SamuelHuet/SerreAutonome/Pics/cuve_filaire.PNG

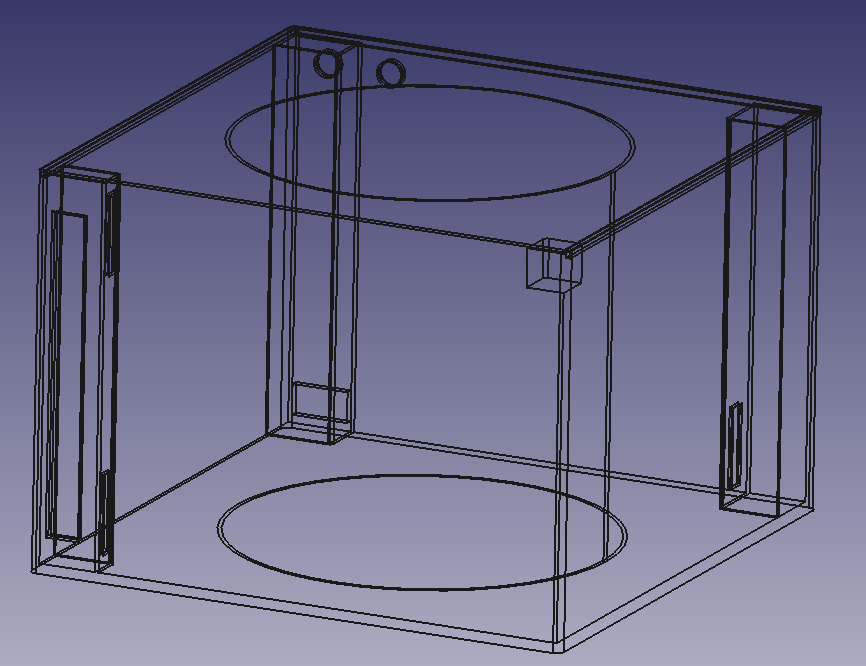
Pics/cuve_filaire.PNG
