SamuelHuet/SerreAutonome/Pics/couvercle_tete_filaire.PNG

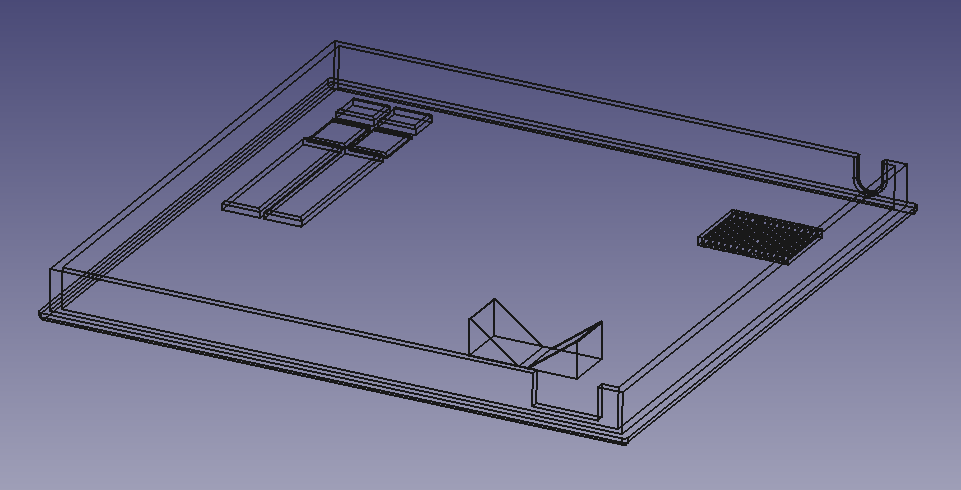
Pics/couvercle_tete_filaire.PNG
