SamuelHuet/SerreAutonome/Pics/Aroser.png

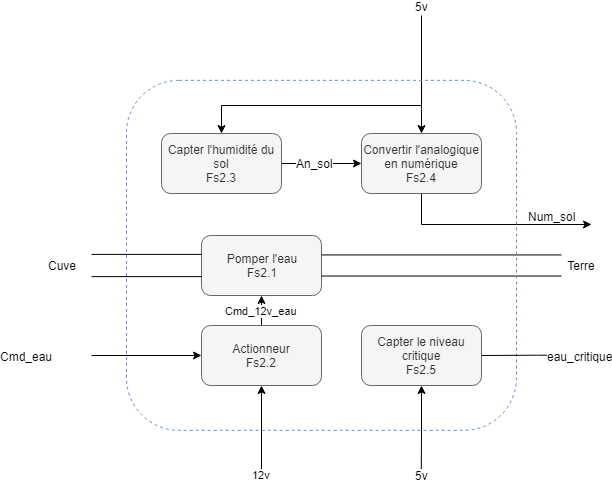
Pics/Aroser.png
