SamuelHuet/SerreAutonome/Pics/Orgnigramme.png

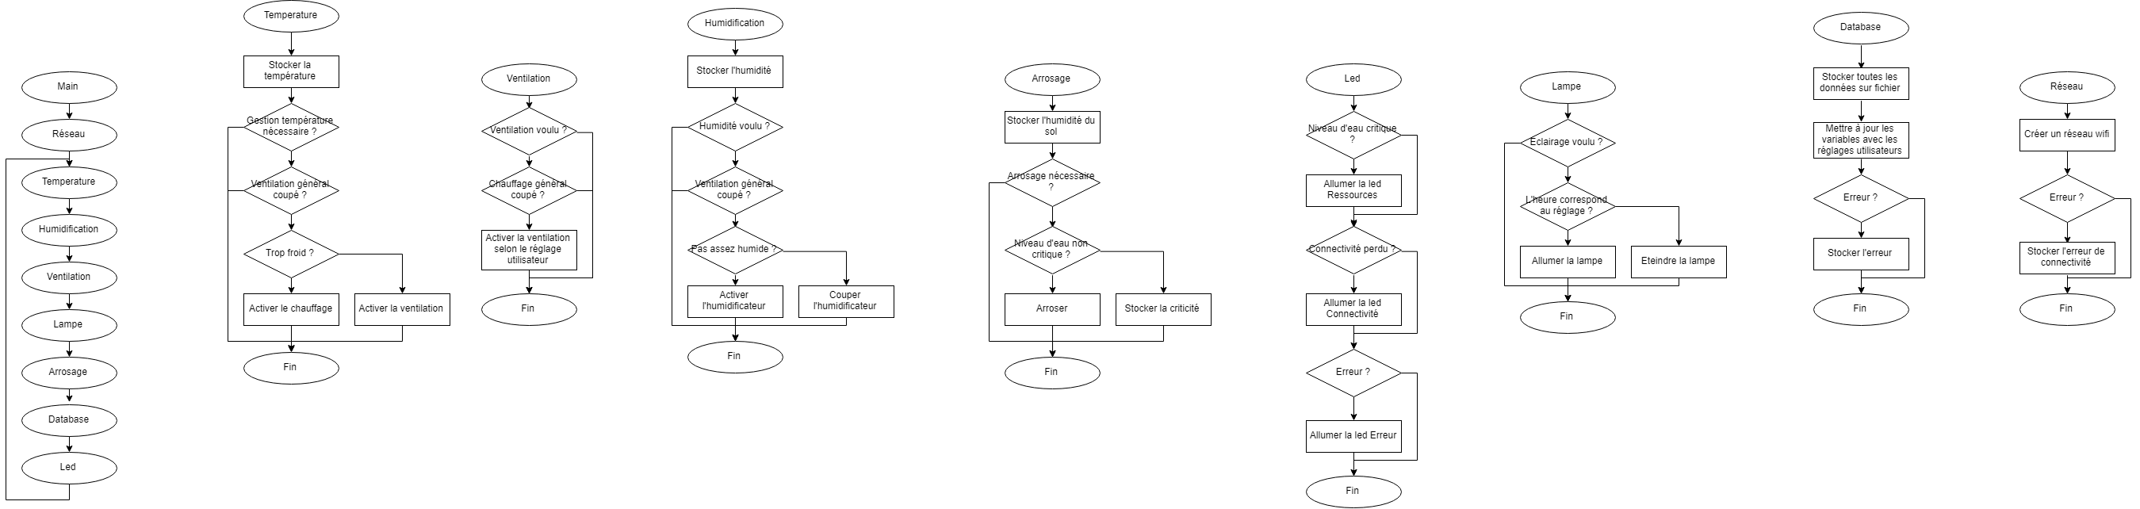
Pics/Orgnigramme.png
