SamuelHuet/SerreAutonome/GreenBox_Altium/Nomenclature.xlsx

COMPOSANT | DESIGNATOR | VALEUR | COMMENTAIRE | FOURNISSEUR | QUANTITE | CODE COMMANDE | REF FABRIQUANT | PRIX UNITAIRE HT | PRIX HT | PRIX TTC
Capacité | C1, C3 | 1µF | format 0805 | Farnell | 1 | 2528779 | C2012X7R1H105K125AE | 2.575 € | 2.575 € | 3.090 €
Capacité | C2, C20 | 0,1µF | format 0806 | Farnell | 1 | 2852354 | C0805C104K1RECAUTO | 1.035 € | 1.035 € | 1.242 €
Capacité | C4, C13 | 10nF | format 0807 | Farnell | 1 | 1759295 | MC0805B103K101CT | 0.526 € | 0.526 € | 0.631 €
Capacité | C5, C6, C7, C8, C14, C15, C16, C21 | 10µF | format 0808 | Farnell | 2 | 1463362 | C0805C106K8PACTU | 0.810 € | 1.620 € | 1.944 €
Capa polarisé | C9, C10, C11, C12, C17, C18, C19 | 100µF | format 0809 | Farnell | 7 | 2254476 | EEETQV101XAP | 0.897 € | 6.279 € | 7.535 €
Diode | D1 |  | 30v/1A | Farnell | 1 | 1017588 | 1N5818 | 1.430 € | 1.430 € | 1.716 €
Zener | D2 |  | 35v/8A | Farnell | 1 | 9556249 | MBRD835LG | 0.683 € | 0.683 € | 0.820 €
Zener | D3 |  | 30v/3,5A | Farnell | 1 | 2646455 | VS-30WQ03FNTR-M3 | 0.693 € | 0.963 € | 1.156 €
Petit bornier | J1, J3, J4 |  | 3 voies | Farnell | 3 | 2396254 | 282834-3 | 2.754 € | 2.754 € | 3.305 €
Gros bornier | J2, J5, J7, J9, J12, J13, J14 |  | 2 voies | Farnell | 7 | 2008021 | MC000050 | 0.873 € | 6.111 € | 7.333 €
Petit bornier | J6, J11 |  | 4 voies | Farnell | 2 | 2396253 | 282834-4 | 4.840 € | 4.840 € | 5.808 €
Petit bornier | J8, J10 |  | 2 voies | Farnell | 1 | 2112482 | 282834-2 | 6.380 € | 6.380 € | 7.656 €
Bobine | L1 | 10µH | 5,3A | Farnell | 1 | 2329043 | SDR1806-100ML | 0.457 € | 0.457 € | 0.548 €
Bobine | L2 | 22µH | 1,1A | Farnell | 1 | 2066945 | 74408943220 | 2.620 € | 2.620 € | 3.144 €
Resistance | R1, R12, R13, R14, R15 | 2k | format 0805 | Farnell | 1 | 2057613 | ERJ6ENF2001V | 1.030 € | 1.030 € | 1.236 €
Resistance | R2, R4, R5, R6, R7, R8, R16 | 10k | format 0806 | Farnell | 1 | 1575900 | MCTC0525B105JT5G | 1.370 € | 1.370 € | 1.644 €
Resistance | R3 | 4.7k | format 0807 | Farnell | 1 | 2073784 | MCMR08X472 JTL | 0.107 € | 0.107 € | 0.128 €
Resistance | R9, R10, R11 | 150R | format 0808 | Farnell | 1 | 1469877 | CRCW0805150RFKEA | 0.141 € | 0.141 € | 0.169 €
Mosfet | T1, T3, T4, T5 |  | N, 9,9A | RS-online | 4 | 760-4413 | IRL6342PBF | 0.466 € | 1.864 € | 2.237 €
Transistor | T2, T6, T7, T8, T9 |  |  | Farnell | 1 | 1081228 | BC846A,215 | 0.590 € | 0.590 € | 0.708 €
ADC | U1 |  |  | Farnell | 1 | 2513624 | MAX1118EKA+T | 1.720 € | 1.720 € | 2.064 €
Relai | U2 |  | 10A | Farnell | 1 | 1891660 | OJE-SS-103HM,000 | 1.220 € | 1.220 € | 1.464 €
Raspberry | U3 |  | Raspberry pi zero w | Kubii | 1 | PIZEROW |  | 8.352 € | 8.352 € | 10.440 €
Alimenation | U4 |  |  | Mouser | 1 | 926-LM2677T-12/NOPB | LM2677T-12/NOPB | 5.360 € | 5.360 € | 6.432 €
Alimenation | U5 |  |  | Mouser | 1 | 926-LM2677S-5.0/NOPB | LM2677S-5.0/NOPB | 5.780 € | 5.780 € | 6.936 €
Alimenation | U6 |  |  | Farnell | 1 | 1087165 | LD1117AV33 | 0.465 € | 0.465 € | 0.558 €
Dissipateurs |  | 11°C/W | TO-220 | Farnell | 1 | 1892327 | SK 104 38,1 STS | 1.580 € | 1.580 € | 1.896 €
Dissipateurs |  | 20°C/W | TO-220 | Farnell | 1 | 595883 | LS305 | 1.410 € | 1.410 € | 1.692 €
Connecteur 220v |  |  | 10A | Digikey | 1 | 708-2406-ND | BZH01/Z0000/11 | 9.264 € | 9.264 € | 11.480 €
Capteur humidité sol |  |  |  | Robotshop | 1 | RB-Dfr-655 |  | 5.130 € | 5.130 € | 6.156 €
Pompe |  |  |  | Aliexpress | 1 |  |  | 7.192 € | 7.192 € | 8.990 €
Ventilateur aération |  |  | San Ace 40 | Farnell | 4 | 2679916 | 9GAX0412P3K003 | 16.620 € | 66.080 € | 79.296 €
Capteur temperature |  |  | DTH22 | Robotshop | 1 | RB-Spa-521 |  | 8.730 € | 8.730 € | 10.476 €
Humidificateur |  |  |  | Aliexpress | 1 |  |  | 3.168 € | 3.168 € | 3.960 €
Chauffage |  |  |  | Aliexpress | 1 |  |  | 5.888 € | 5.888 € | 7.360 €
Ventilateur chauffage |  |  |  | Mouser | 1 | 108-AFB0612MC | AFB0612MC | 11.760 € | 11.760 € | 14.112 €
Leds |  |  |  | Farnell | 1 | 2099235 | KPT-2012CGCK | 0.975 € | 0.975 € | 1.170 €
Alimentation |  |  |  | Aliexpress | 1 |  |  | 10.424 € | 10.424 € | 13.030 €
 |  |  |  |  |  |  |  | TOTAL | 197.87 € | 239.56 €
