SamuelHuet/SerreAutonome/Model3D/Tête.FCStd

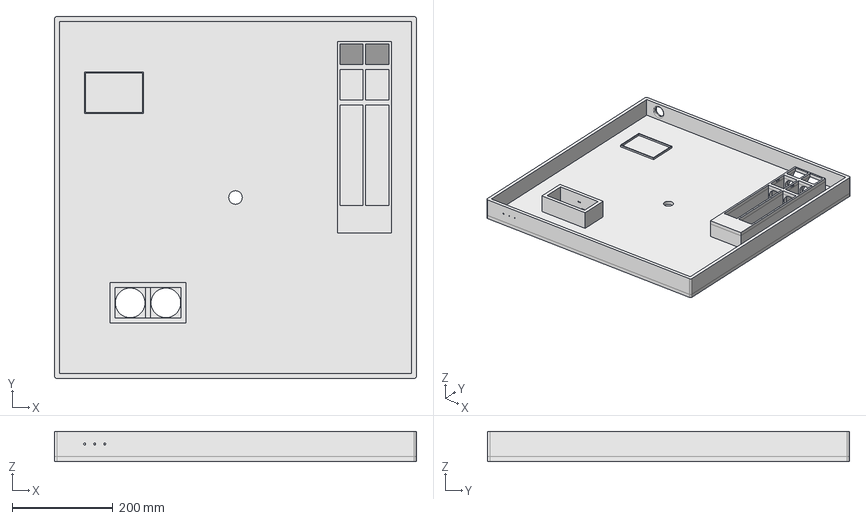
[picture p57: CAD file, 2019-10-08]
Model3D/Tête.FCStd
720.0 x 720.0 x 60.0 mm
