SamuelHuet/SerreAutonome/Model3D/Couvercle_cuve.FCStd

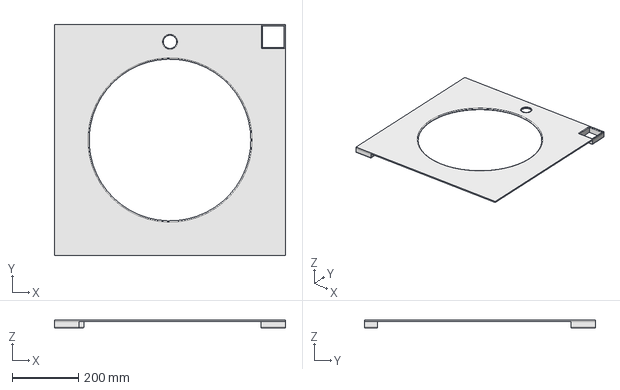
[picture p58: CAD file, 2019-10-08]
Model3D/Couvercle_cuve.FCStd
700.0 x 700.0 x 25.0 mm
