SamuelHuet/SerreAutonome/Model3D/GREENBOX.FCStd

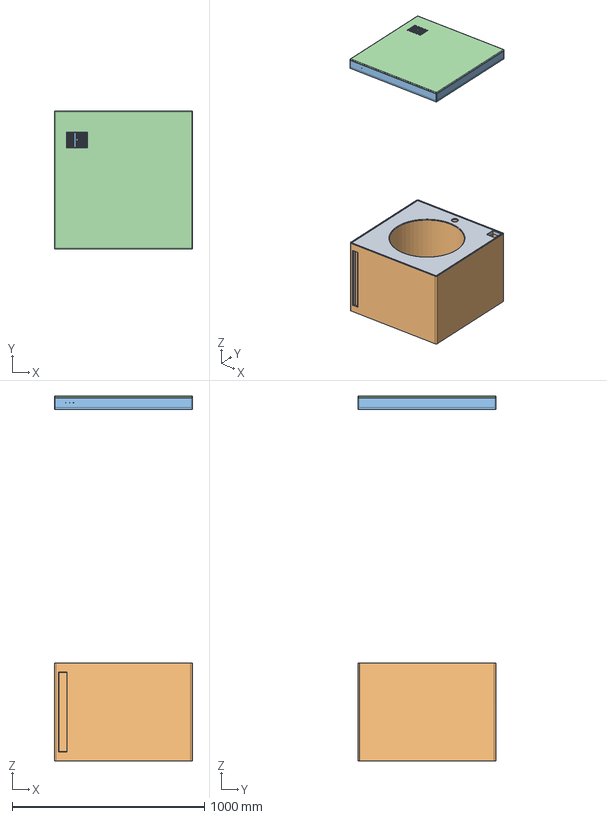
[picture p59: CAD file, 2019-10-08]
Model3D/GREENBOX.FCStd
720.6 x 720.3 x 1899.6 mm
Couvercle_001
Cuve_001
Tête_001
Couvercle_tete_001
