SamuelHuet/SerreAutonome/Model3D/Cuve.FCStd

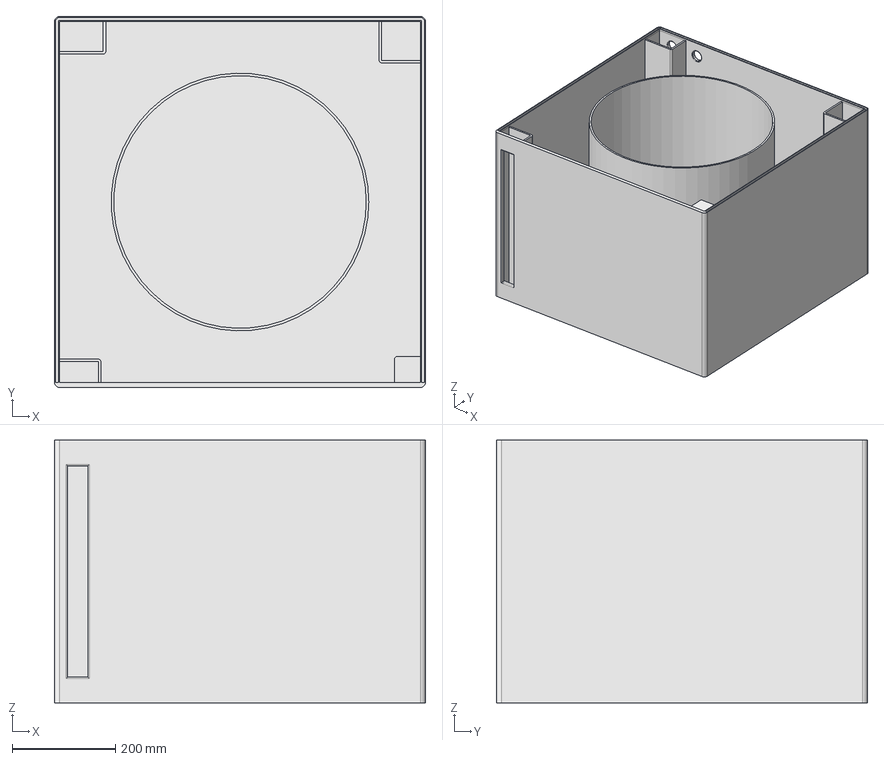
[picture p60: CAD file, 2019-10-08]
Model3D/Cuve.FCStd
720.0 x 720.0 x 510.0 mm
