SamuelHuet/SerreAutonome/Model3D/Couvercle_tete.FCStd

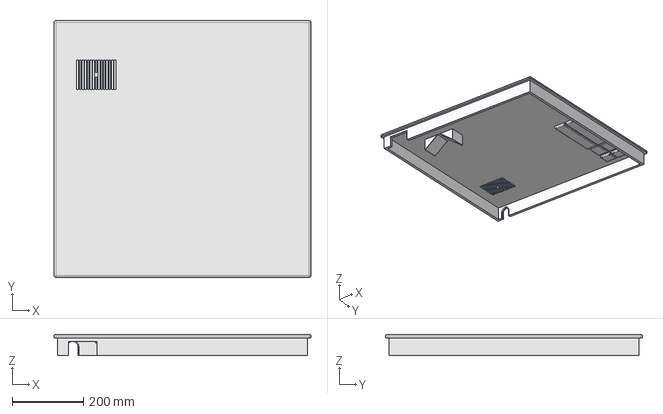
[picture p61: CAD file, 2019-10-08]
Model3D/Couvercle_tete.FCStd
720.0 x 720.0 x 60.0 mm
