SamuelHuet/SerreAutonome/GreenBox_Altium/GreenBox_Altium.pdf

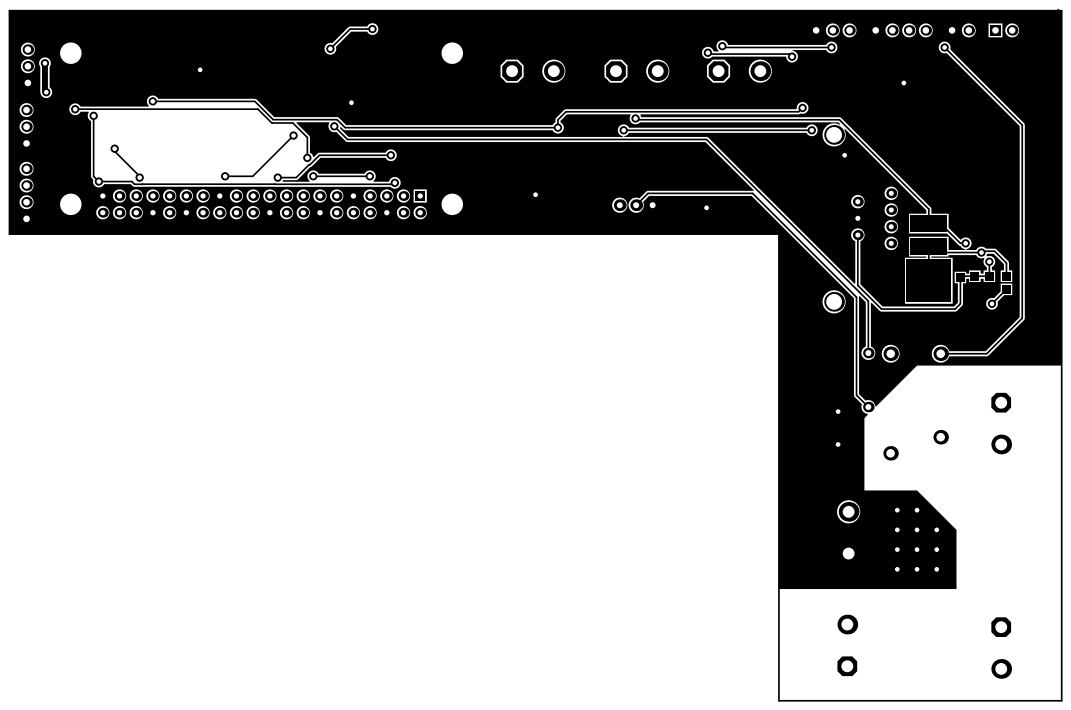
[picture p62: page 1]

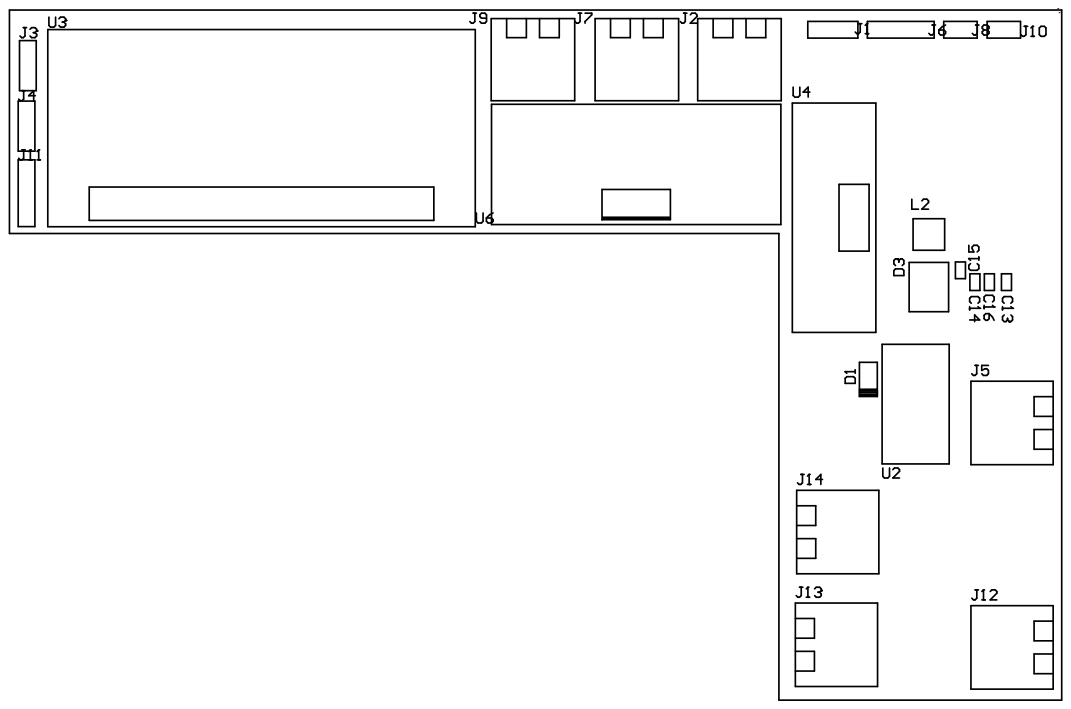
[picture p63: page 2]

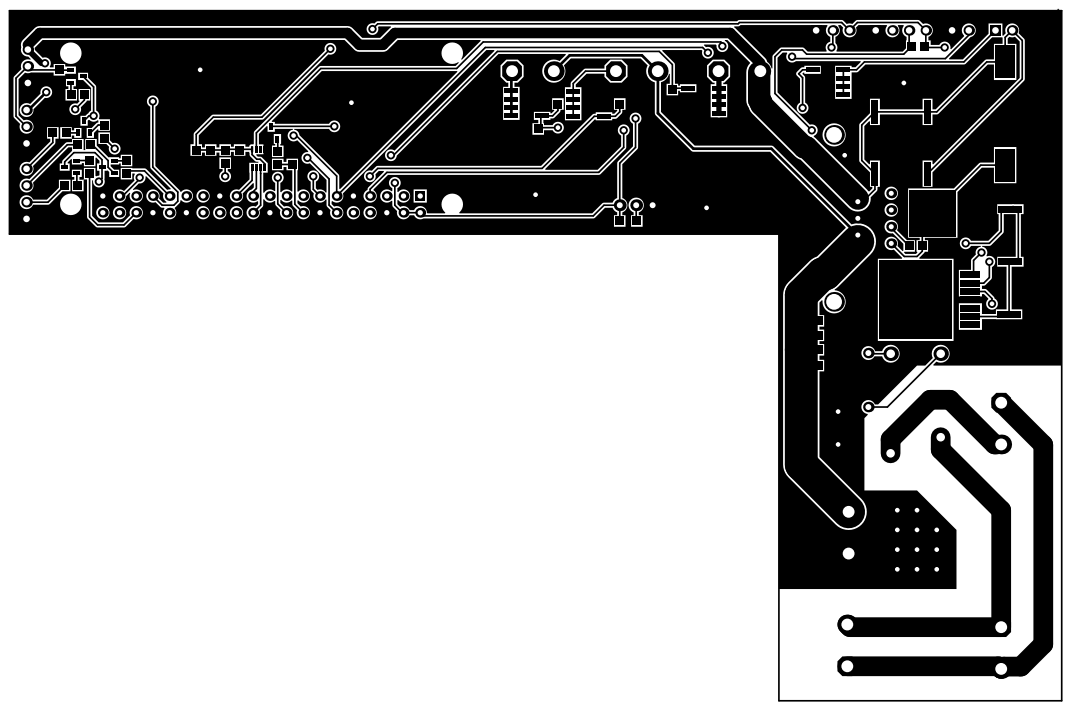
[picture p64: page 3]

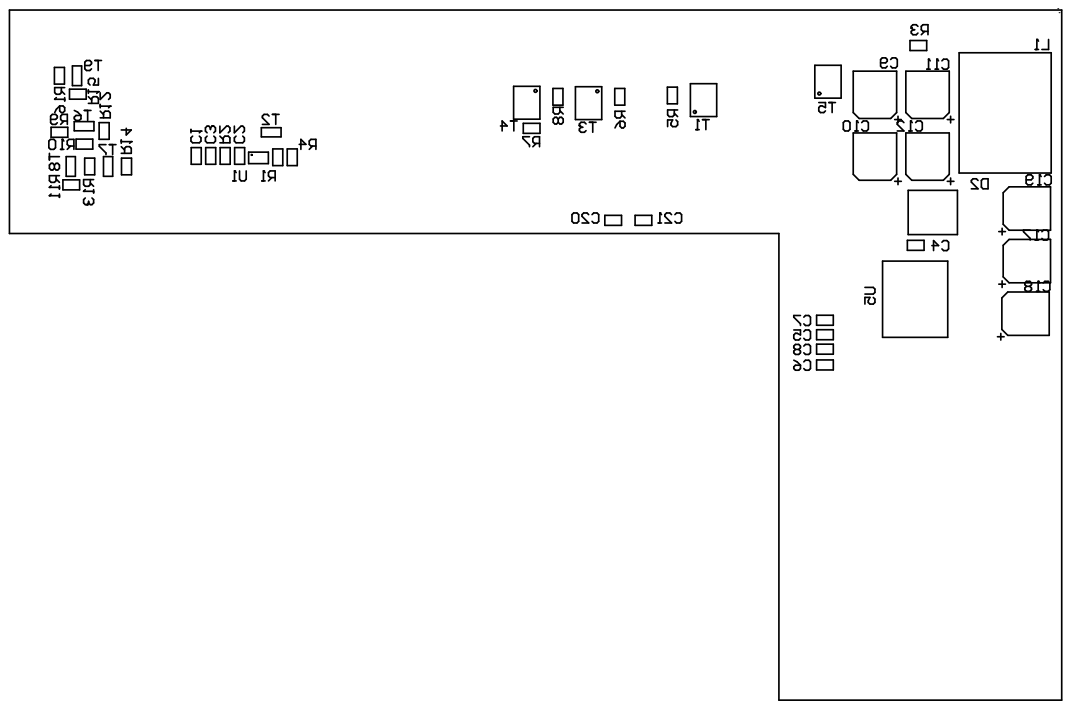
[picture p65: page 4]

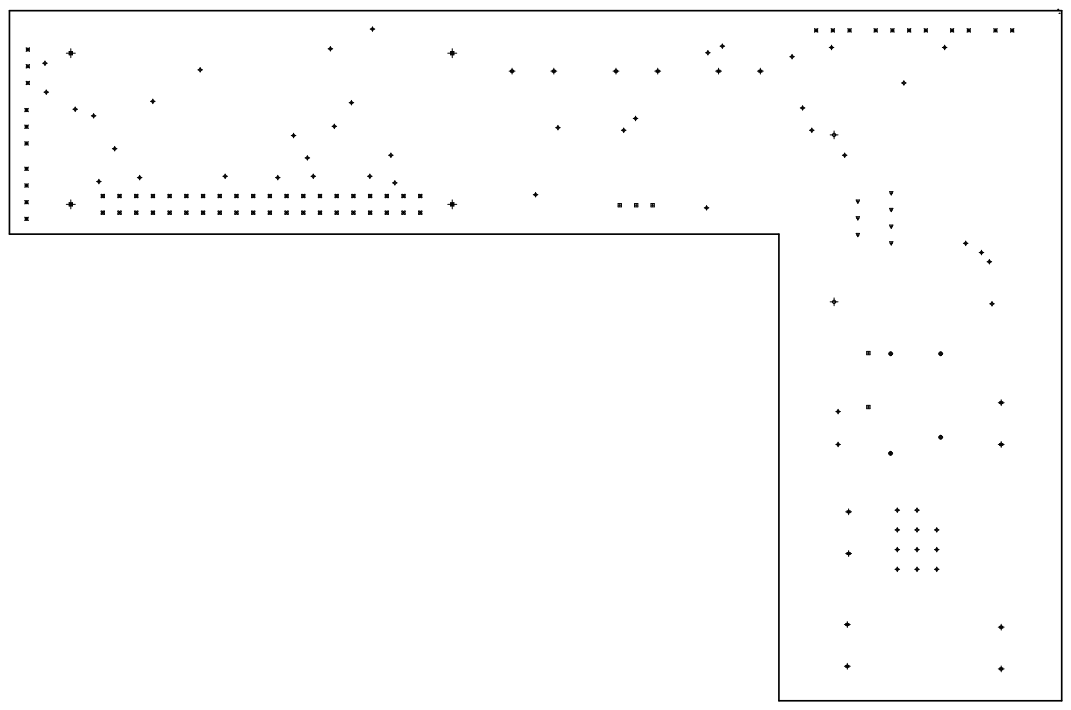
[picture p66: page 5]

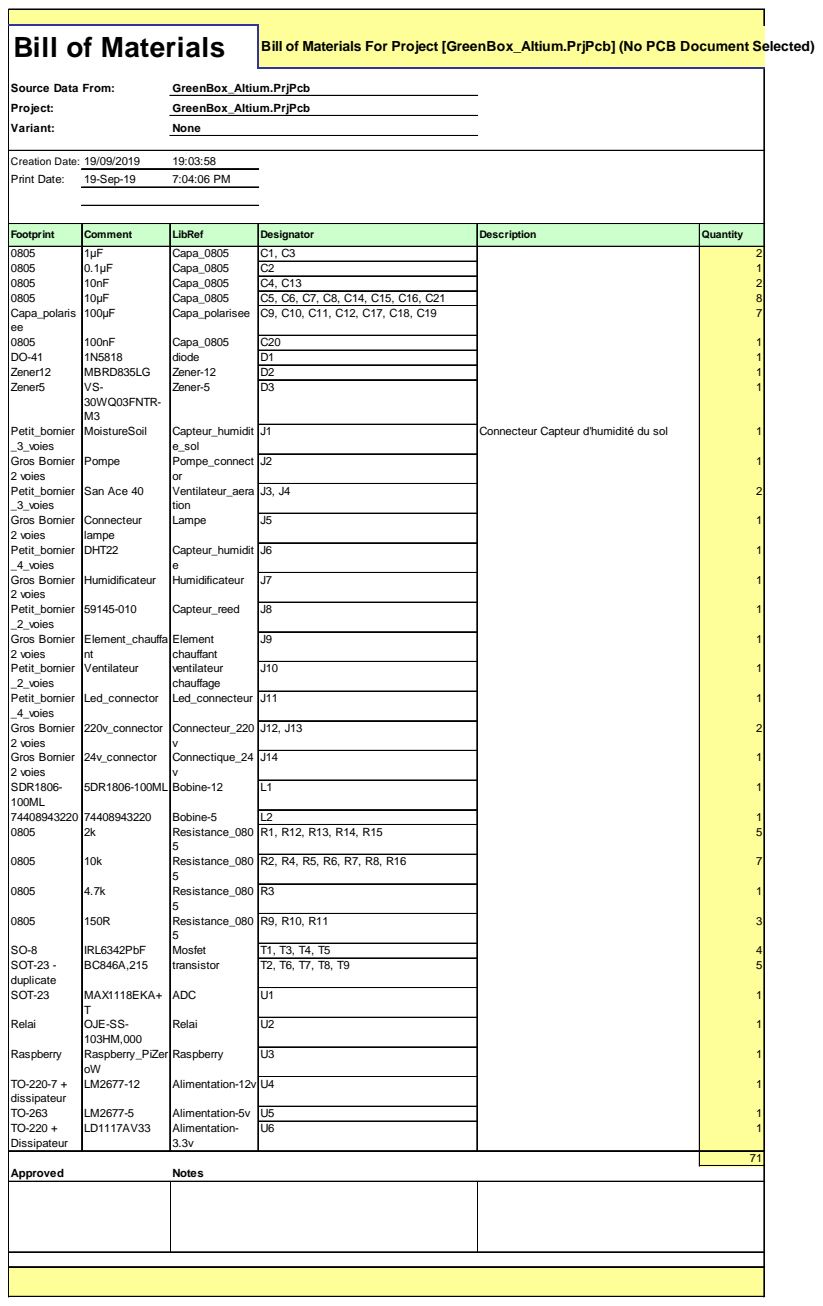
[picture p67: page 6]
