SamuelHuet/SerreAutonome/GreenBox_Altium/GreenBox_sheet.pdf

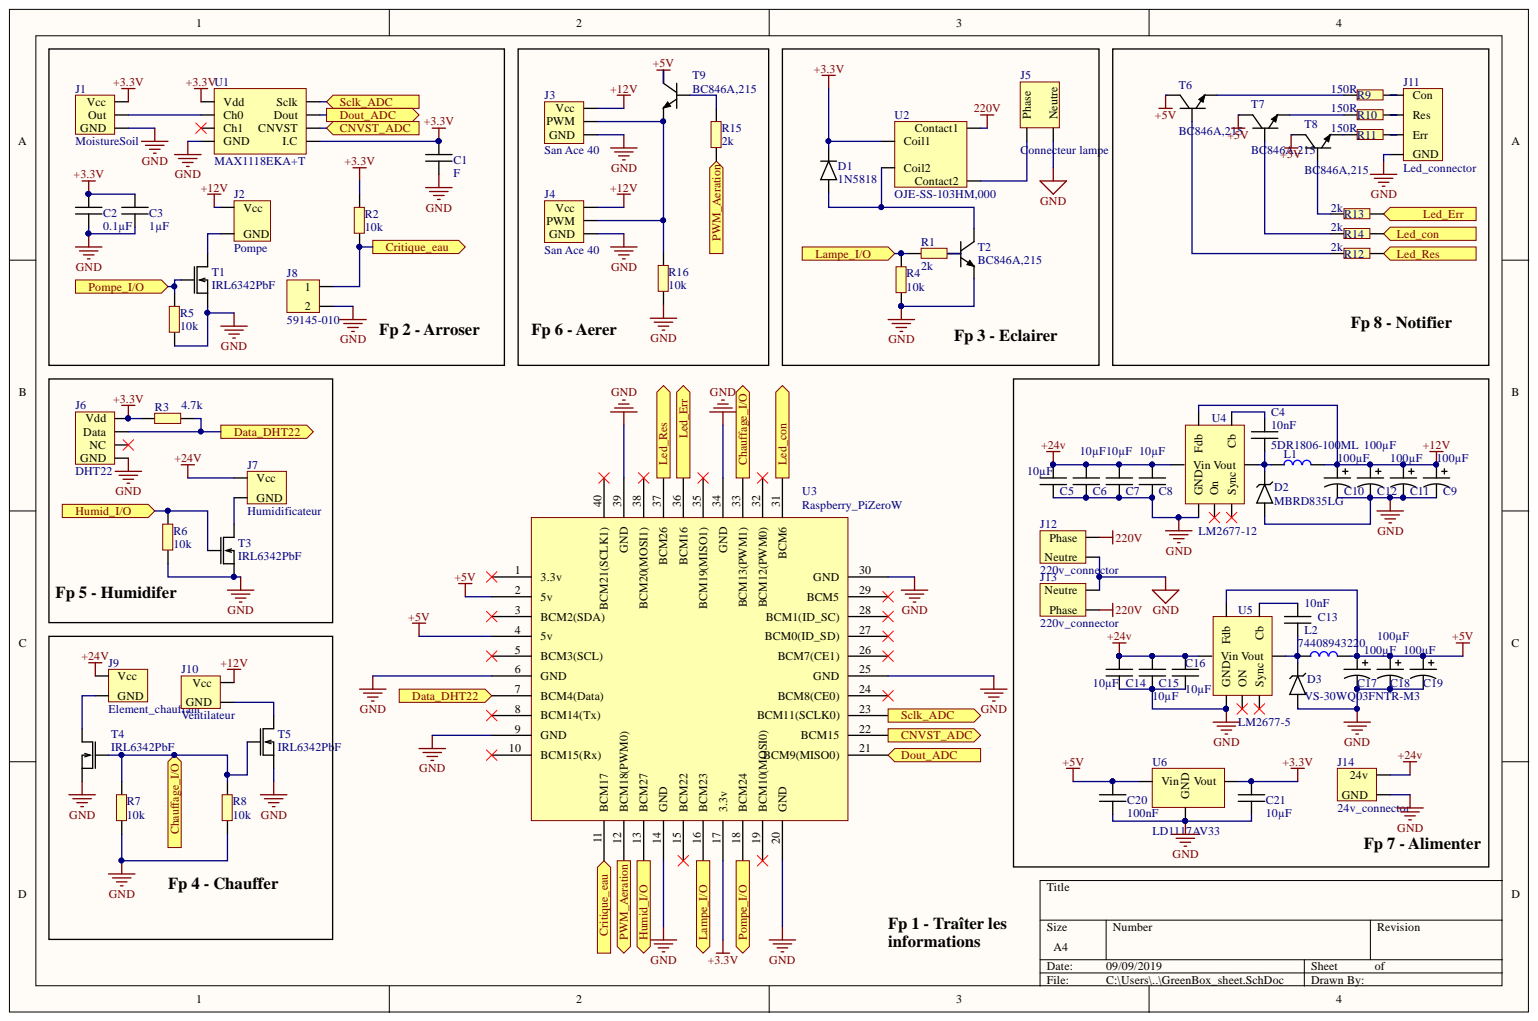
[picture p68: page 1]
