SamuelHuet/SerreAutonome/(list of files, drawings)

Other design files:
GreenBox_Altium/GreenBox_Altium.PrjPcb
GreenBox_Altium/GreenBox_pcb.PcbDoc
GreenBox_Altium/GreenBox_PCBLib.PcbLib
GreenBox_Altium/GreenBox_sheet.SchDoc
GreenBox_Altium/GreenBox_SheetLib.SchLib
